pierrotm777/Sound_Module/kemo_m033n.png

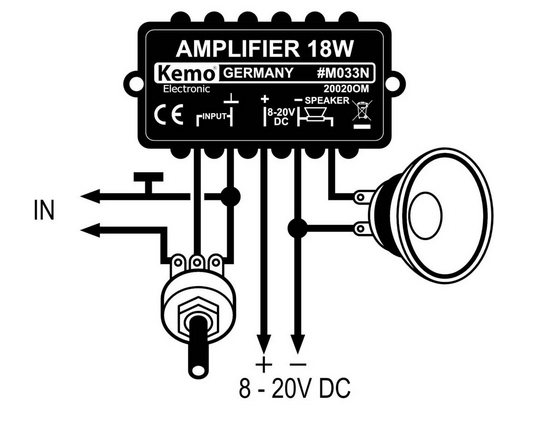
kemo_m033n.png
