pierrotm777/Sound_Module/relais.png

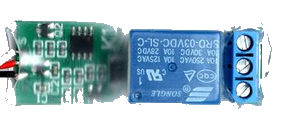
relais.png
