pierrotm777/Sound_Module/Sound_Module_Xany_Top.png

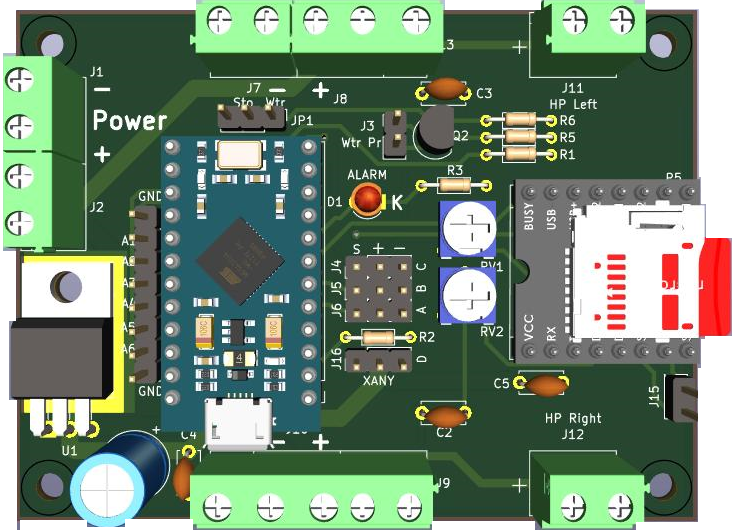
Sound_Module_Xany_Top.png
