pierrotm777/Sound_Module/(commit log)

2024-06-10 Add firmware
    Two version:
    - normal: PWM, CPPM (No Xany)
    - Xany: PWM,CPPM,SBUS,IBUS,SUMD,SRXL,JETIEX and Xany mode
2024-06-10 add pcb xany version
2024-07-02 Update
    - update firmware
    - add kicad and gerber v1.1 files
    - update doc
2024-11-07 Update Normal firmware
    - add 8 buttons option
